N-Pulse/Transradial-Prosthesis-PWR-HW/power_supply (1).pdf

# Power Board

## EPFL N-Pulse

## Lugon-Moulin Johann

EPFL

February 26, 2025

Projet de conception de m´ecanisme: capteur de forces | 3 DESIGN CONSIDERATIONS

## 1 Introduction

The purpose of this report is to explain all the steps leading up to the last version of the PCB. Different design considerations are discussed and explained.

The purpose of this part of the project is to supply the power that comes from the battery to other devices in the arm. For that we need to split it into branches with different voltage and current levels depending on the device (c.f. Figure1).

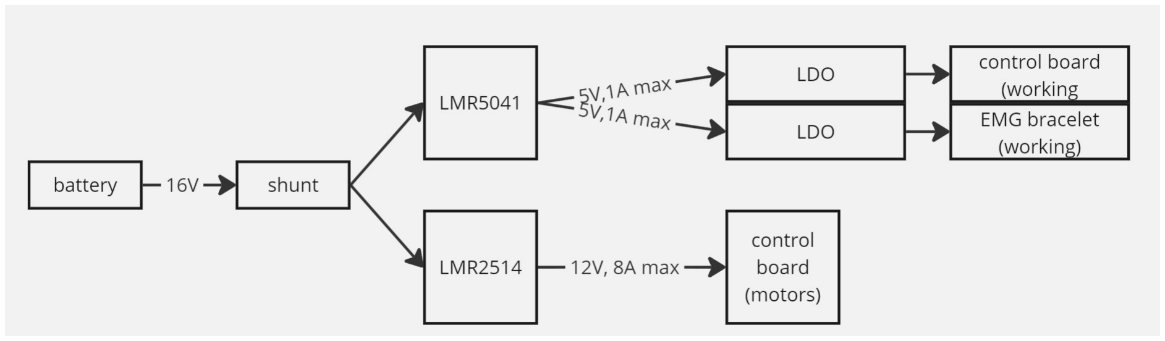
[picture p1: figure]

Figure 1: Schematics

## 2 Requirements

Input : 16.8V to 12V;
Output: 12V (Motors) and 5V (EMG and Control Board);
Size: Mechanical constraints;
Power dissipation : as low as possible to avoid component burning and harming the user.

## 3 Design Considerations

- Current Mirror

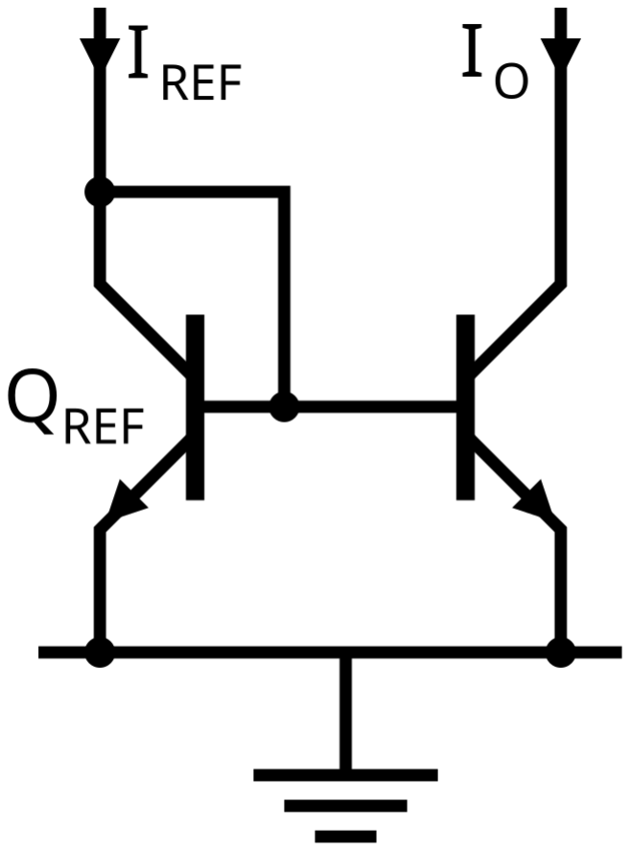
[picture p2: figure]

Figure 2: Current Mirror

The advantage is that it can be easily integrated in a PCB and a simple circuit. However, this design outputs a constant current level regardless of the system’s requirements. Outputting too much current will empty the battery much faster and potentially damage other parts of the system which do not require high current.

- LDO
The LDO system is a way of reducing voltage level through heat dissipation. If the voltage drop is too high the temperature can increase very fast which can damage the PCB. On the other hand, they are simple, inexpensive and the output voltage is low-noise (as opposed to a buck regulator).

Projet de conception de m´ecanisme: capteur de forces | 4 12V CIRCUIT

## 4 12V Circuit

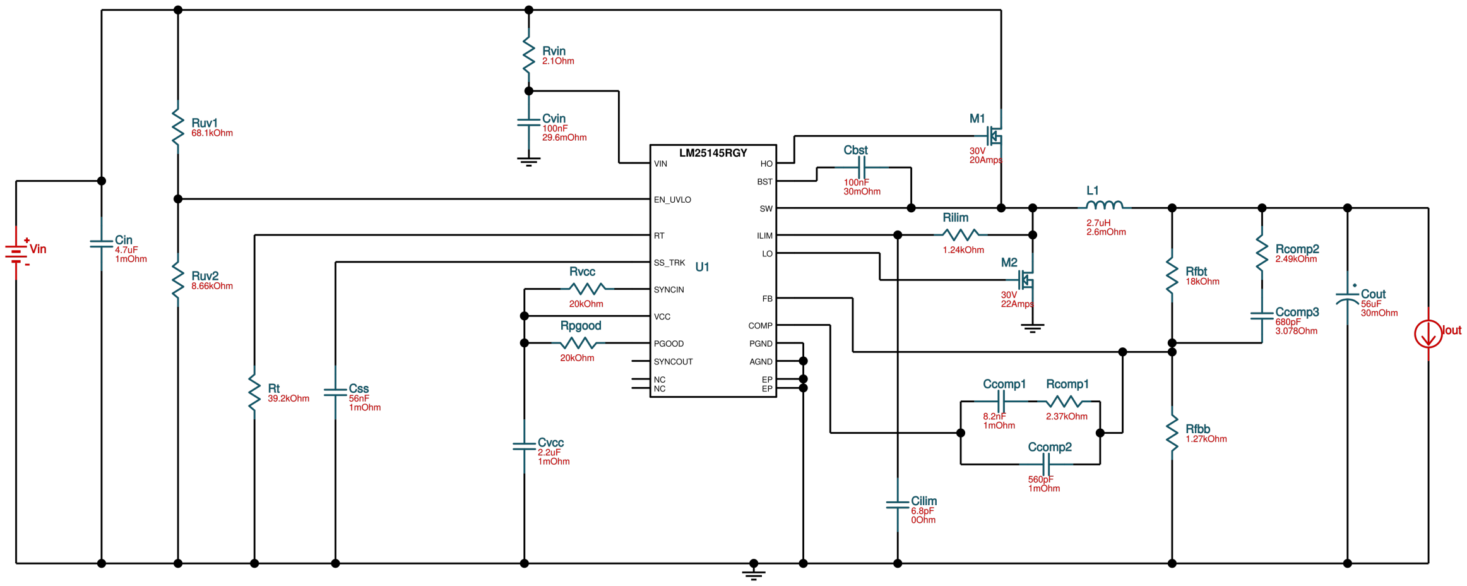
[picture p3: figure]

Figure 3: 12V, 8A circuit designed by Webench

This circuit is made to supply the motors of the arm which work with 12V. To design the circuit, we had to estimated the maximum current value passing through this branch to power the motors. Each motor has a stall current of 0.5A. The arm prosthesis is designed to contain a maximum of 8 motors. As such, the maxmimum current requirements for all the motors in stall mode is 4A. To avoid breaking the system if the current suddenly increases, a safety margin of +0.5A is considered per motor which implies that the circuit should ultimately accept 8A.

### 4.1 Circuit Properties

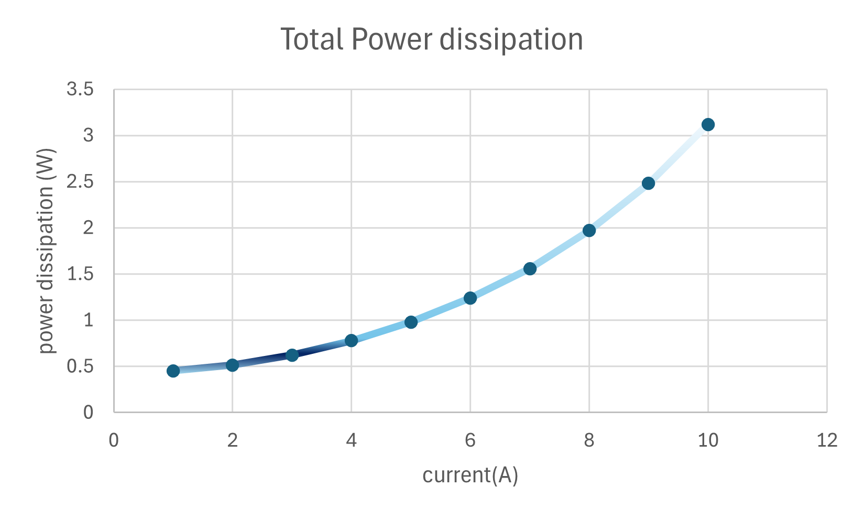
[picture p4: figure]

Figure 4: Caption

### 4.2 Components

Projet de conception de m´ecanisme: capteur de forces | 4 12V CIRCUIT
Category | model | values | mark | number | Figure3
Capacitors | GRM32ER71H475KA88L | 4.7uF50V | murata electronics | 1 | Cin
resistor | CRCW040269K8FKED | 69.8k | Vishay | 1 | Ruv1
resistor | CRCW06038K25FKEA | 8.25k | Vishay | 1 | Ruv2
resistor | CRCW06032R10FKEA | 2.10ohms | Vishay | 1 | Rvin
Condensator | CGA3E2X7R1H104K080AA | 0.1uF | TDK | 1 | Cvin
Resistor | CRCW040239K2FKED | 39.2k | Vishay | 1 | Rt
Condensator | GRM155R71C563KA88D | 56nF | murata electronics | 1 | Css
Condensator | C1005X5R1V225K050BC | 2.2uF | TDK | 1 | Cvcc
resistor | RC0603FR-0720KL | 20k | Yageo | 2 | Rvcc Rpgood
Transitors | CSD17577Q3A | 35A Id, 30V | texas instrument | 1 | M2 M1
condensator | GCM1555C1H100FA16D | 10pF(echange) | Murata electronics | 1 | Cbst
Resistor | CRCW04021K24FKED | 1.24k Ohms | Vishay | 1 | Rilim
Condensator | GRM1885C2A100JA01D | 10pF | murata electronics | 1 | Cilim
Resistor | CRCW04022K37FKED | 2.37k | Vishay | 1 | Rcomp1
Condensator | GRM155R71C822KA01D | 8200pF | Murata Electronics | 1 | Ccomp1
Condensator | CGA2B2X7R1H681K050BA | 680pF | TDK | 1 | Ccomp2
Inductance | SER1360-272KLD | 2.7uH | Coilcraft | 1 | L1
Resistor | RC0603FR-0718KL | 18k | Yageo | 1 | Rf bt
Resistor | CRCW04021K27FKED | 1.27K | Vishay | 1 | Rf bb
Resistor | CRCW04022K49FKED | 2.49k | vishay | 1 | Rcomp2
Condensator | CGA2B2X7R1H681K050BA | 680pF | TDK | 1 | Ccomp3
Condensators | 20SVPF56MX | 56uF | Panasonic | 1 | Cout
- pin connectors
We transfer all the current to the control board with 2 pins that will have a current max of 10A (worst case). The pin have a a pitch of 5mm

### 4.3 PCB traces

We need to be carefull with the traces to avoid that they burns. The current that pass in the trace heat the trace and if the resistance is to high the trace can burn after a certain time. The value of the current is an RMS value. To have security margins, we take the RMS current as 3.5A ( the case where all the motors work at the maximum in the same time). The 8A will not burn our traces because it will occur only in the worst case and a really short time.
We can have multiple ways of impact the surface of the trace to reduce this resistance. The easiest is during the manufacturing with a change in the thickness (more common are 1oz and 2oz). The calculation depend on the ambiant temperature: we take 25°C. It depend on the temperature rise: we take 10°C. There is a calculation to find what to use.
| A =
| | I
| | k · (Trise) b

1
| | c
(1)

W =

A
t · 1.378

(2)

avec :

- A : surface
- W : trace width
- I : Current(A)
- k : Coefficient of proportion for internal layers : 0.024
- Trise : Temperature rise
- b : empirical exposant for internal layers : 0.44
- c : correctionnal exposant for internal layers : 0.725
- t : thickness

Projet de conception de m´ecanisme: capteur de forces | 4 12V CIRCUIT

Results

thickness of 1oz : W = 4, 398786766mm thickness of 2oz : W = 2, 199393383mm

In our PCB, the big traces are only where the current can be high and the other traces are normal (=0.2mm)

Projet de conception de m´ecanisme: capteur de forces | 6 FUSE

## 5 5V Circuit

The purpose of this circuit is to power the Control Board as well as the EMG bracelet. For this section we estimate that the current should not exceed 1A.

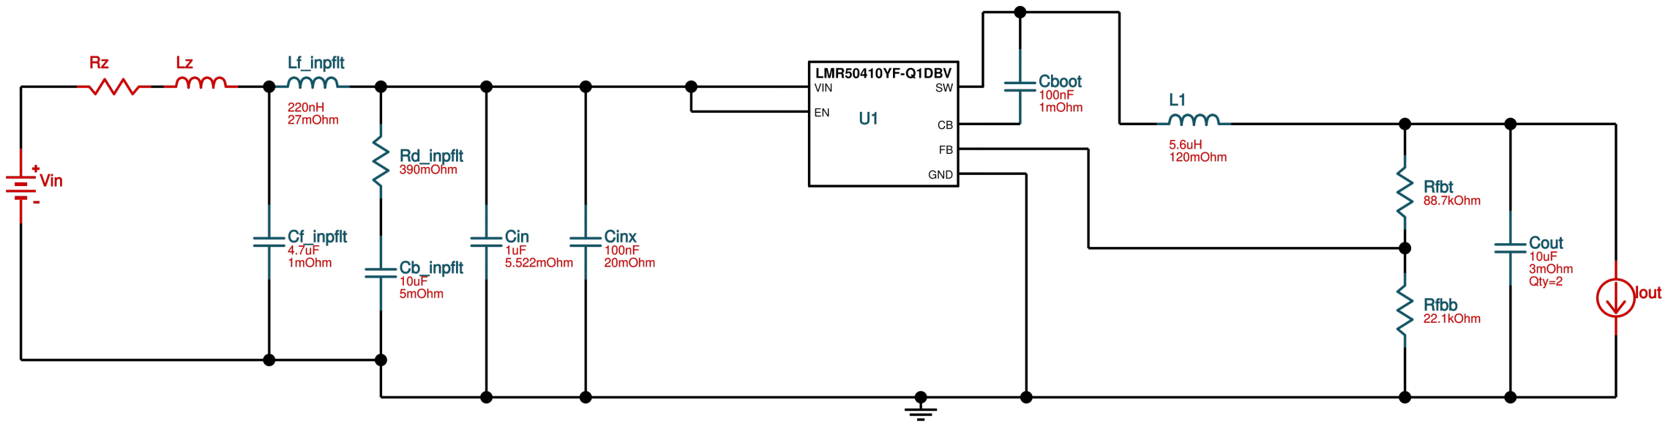
[picture p5: figure]

Figure 5: 5V, 1A Circuit made by Webench

### 5.1 Components

Category | model | values | mark | number | Figure5
Inductor | NLCV32T-R33M-EFRD | 0.33uH | TDK | 1 | Lfinplif t
Capacitors | GRM31CR71H475KA12L | 4.7uF | murata elec | 1 | Cfinplif t
Resistor | CRCW04021R00FKED | 1 ohm | Vishay | 1 | Rdinplif t
Capacitors | C3225X7S2A475M200AB | 10uF | TDK | 1 | Cbinplif t
Capacitors | C1608X5R1E106M080AC | 1uF | TDK | 1 | Cin
Capacitors | GRM188R72A104KA35J | 0.1uF | murata elec | 1 | Cinx
Capacitors | GRM155R71C104KA88D | 0.1uF | murata elec | 1 | Cboot
Inductor | 74438336047 | 4.7uH | wurth electronic | 1 | L1
Resistor | CRCW040288K7FKED | 88.7K | Vishay | 1 | Rf bt
Resistor | CRCW040222K1FKED | 22.1K | Vishay | 1 | Rf bb
Capacitors | C0805C106K8PACTU | 10uF | KEMET | 2 | Cout

## 6 Fuse

The fuse that we have chosen can tolerate a certain amount of peak current (c.f. ”Typical I2t” as shown in Figure 6). The model we selected is the SF-1206HH120M-2. Its nominal current is take to the max that the circuit can tolerate for a long time. All the components of the power board can tolerate 8A.

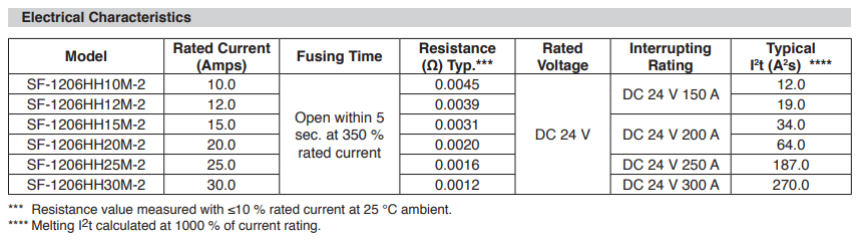
[picture p6: figure]

Figure 6: Fuse Characteristics

Projet de conception de m´ecanisme: capteur de forces | 7 FINAL PCB

## 7 Final PCB

We have a PCB with 2 layers due to the fact that some traces should pass on the bottom layer to avoid to crossing with others.

Final Dimensions: 38.35mm x 37.5mm x 7mm

The 2 holes are to fix the PCB inside the arm and they are M2

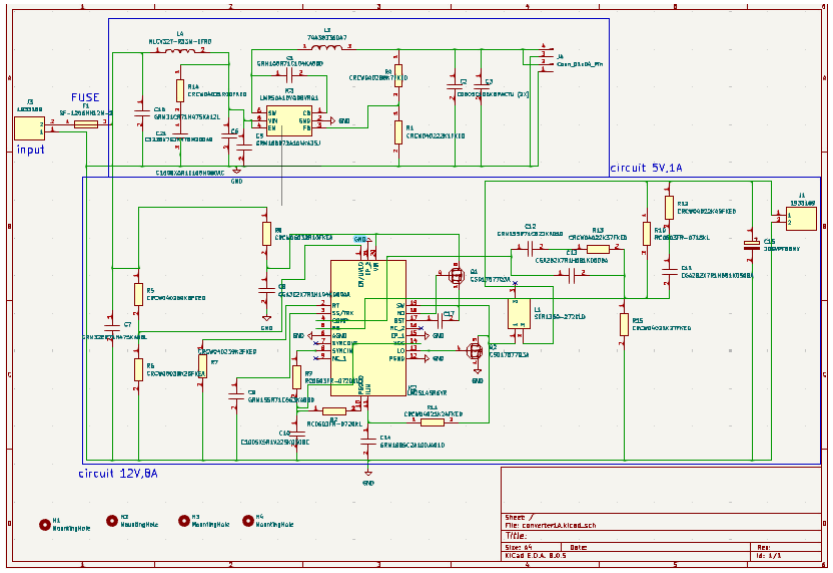
[picture p7: figure]

Figure 7: KiCad Circuit Schematics

Projet de conception de m´ecanisme: capteur de forces | 7 FINAL PCB

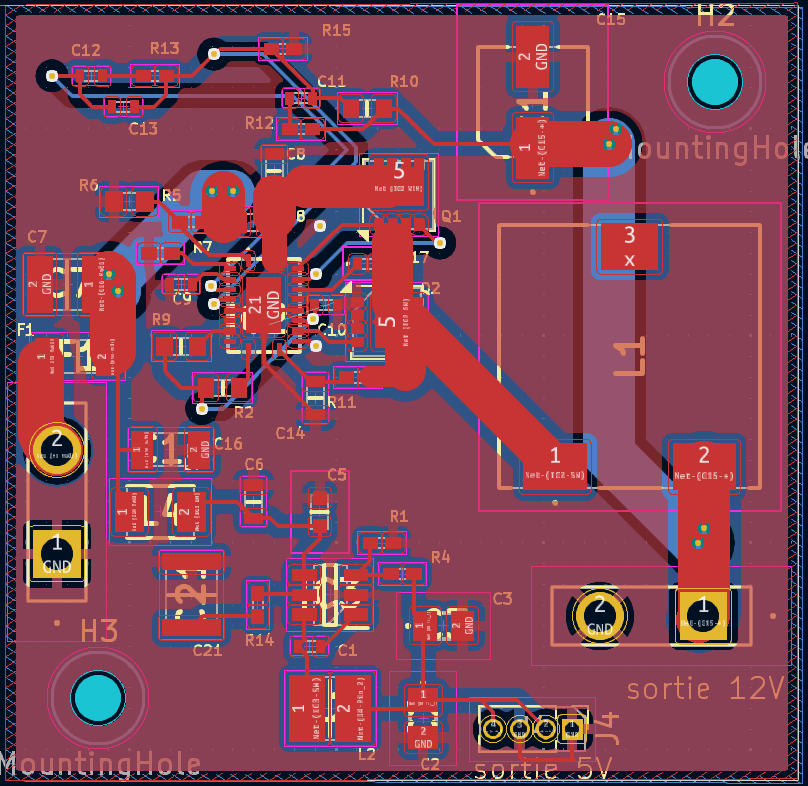
[picture p8: figure]

Figure 8: board PCB

Projet de conception de m´ecanisme: capteur de forces | 7 FINAL PCB

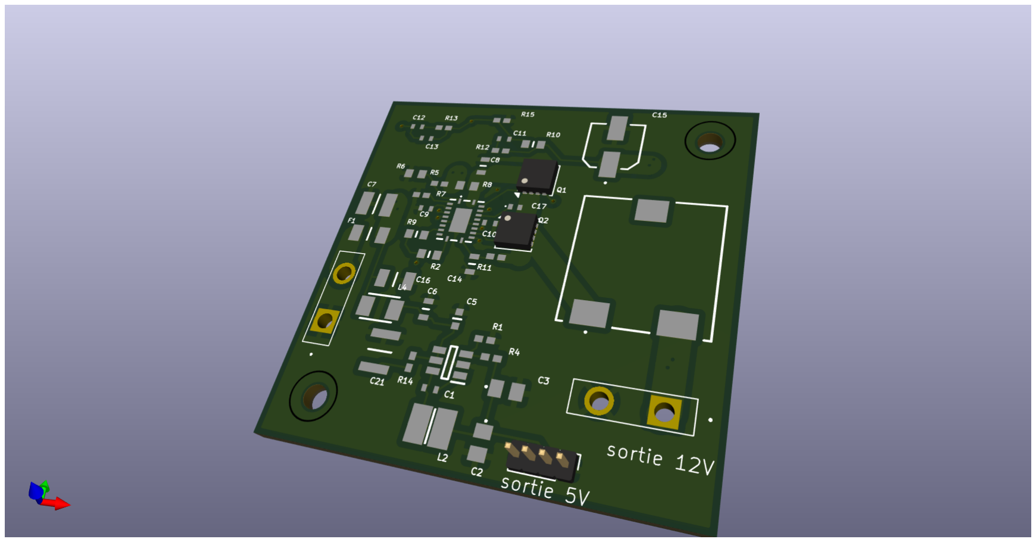
[picture p9: figure]

Figure 9: PCB 3D model
