N-Pulse/Transradial-Prosthesis-PWR-HW/power supply v2/converter1A.kicad_pcb

## KiCad design power supply v2/converter1A.kicad_pcb (2025-03-12)

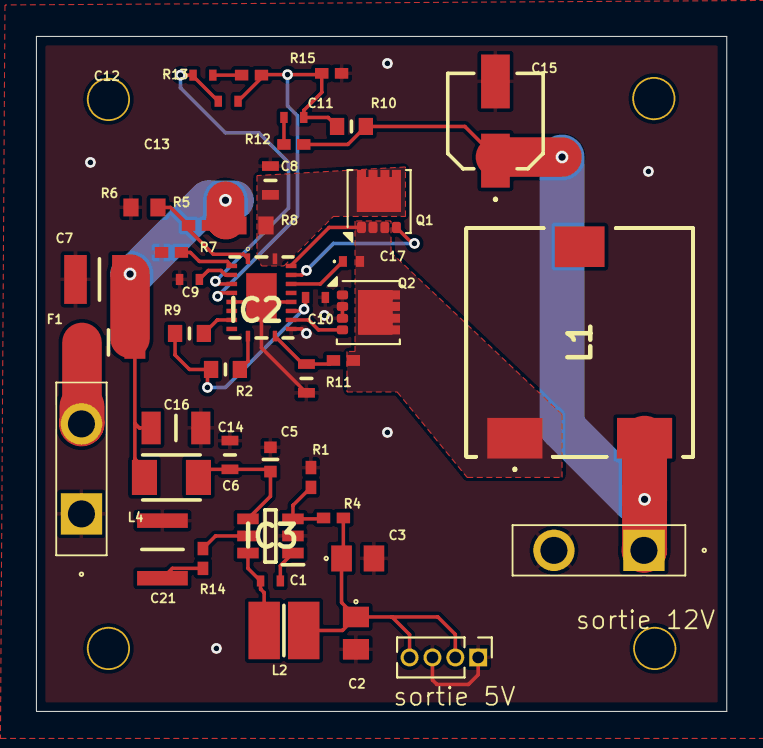
[picture p10: board converter1A.kicad_pcb from above]

Board: 2 copper layers, 38.3 x 37.5 mm, 46 parts (0 on the bottom side), 26 nets.

Parts:
C1: GRM155R71C104KA88D; CAPC1005X55N
C2: C0805C106K8PACTU; C0805
C3: C0805C106K8PACTU (2X); C0805
C5: GRM188R72A104KA35J; GRM18x
C6: C1608X5R1E106M080AC; CAPC1608X80N
C7: GRM32ER71H475KA88L; CAPC3225X270N
C8: CGA3E2X7R1H104K080AA; CAPC1608X90N
C9: GRM155R71C563KA88D; CAPC1005X55N
C10: C1005X5R1V225K050BC; CAPC1005X55N
C11, C13: CGA2B2X7R1H681K050BA; CAPC1005X55N
C12: GRM155R71C822KA01D; CAPC1005X55N
C14: GRM1885C2A100JA01D; CAPC1608X90N
C15: 20SVPF56MX; 16SVF82M
C16: GRM31CR71H475KA12L; CAPC3216X180N
C17: GCM1555C1H100FA16D; GCM155
C21: C3225X7S2A475M200AB; CAPC3225X200N
F1: SF-1206HH12M-2; FUSC3216X117N
H2, H2#2, H3, H3#2: MountingHole; MountingHole_2.2mm_M2
IC2: LM25145RGYR; RGY0020B
IC3: LMR50410YQDBVRQ1; SOT95P280X145-6N
J1, J3: 1933189
J4: Conn_01x04_Pin; PinHeader_1x04_P1.27mm_Vertical
L1: SER1360-272KLD; SER1360272KLD
L2: 74438336047; INDC3030X200N
L4: NLCV32T-R33M-EFRD; INDPM3225X240N
Q1, Q2: CSD17577Q3A; VSON-8_3.3x3.3mm_P0.65mm_NexFET
R1: CRCW040222K1FKED; RESC1005X40N
R2, R9: RC0603FR-0720KL; RESC1608X55N
R4: CRCW040288K7FKED; RESC1005X40N
R5: CRCW040269K8FKED; RESC1005X40N
R6: CRCW06038K25FKEA; RESC1608X50N
R7: CRCW040239K2FKED; RESC1005X40N
R8: CRCW06032R10FKEA; RESC1608X50N
R10: RC0603FR-0718KL; RESC1608X55N
R11: CRCW04021K24FKED; RESC1005X40N
R12: CRCW04022K49FKED; RESC1005X40N
R13: CRCW04022K37FKED; RESC1005X40N
R14: CRCW04021R00FKED; RESC1005X40N
R15: CRCW04021K27FKED; RESC1005X40N

Connections:
GND: C2.2, C3.2, C5.2, C6.2, C7.2, C8.2, C9.2, C10.2, C14.2, C15.2 (-), C16.2, C21.2, IC2.6 (AGND), IC2.12 (PGND), IC2.15 (EP_1), IC2.21 (EP_2), IC3.2 (GND), J1.2, J3.1, J4.1, J4.3, Q2.1 (S), Q2.2 (S), Q2.3 (S), R1.2, R6.2, R7.2, R15.2
unnamed: C11.1, R12.2
unnamed: C12.2, R13.1
unnamed: C15.1 (+), J1.1, L1.2, R10.1, R12.1
unnamed: C7.1, C16.1, F1.2, L4.1, R5.1, R8.1
unnamed: C21.1, R14.2
unnamed: F1.1, J3.2
unnamed: C17.1, IC2.17 (BST)
unnamed: C12.1, C13.1, IC2.4 (COMP)
unnamed: IC2.1 (EN/UVLO), R5.2, R6.1
unnamed: C11.2, C13.2, IC2.5 (FB), R10.2, R13.2, R15.1
unnamed: IC2.18 (HO), Q1.4 (G)
unnamed: C14.1, IC2.11 (ILIM), R11.1
unnamed: IC2.13 (LO), Q2.4 (G)
unnamed: IC2.10 (PGOOD), R2.2
unnamed: IC2.2 (RT), R7.1
unnamed: C9.1, IC2.3 (SS/TRK)
unnamed: C17.2, IC2.19 (SW), L1.1, Q1.1 (S), Q1.2 (S), Q1.3 (S), Q2.5 (D), R11.2
unnamed: IC2.8 (SYNCIN), R9.1
unnamed: C10.1, IC2.14 (VCC), R2.1, R9.2
unnamed: C8.1, IC2.20 (VIN), Q1.5 (D), R8.2
unnamed: C1.2, IC3.1 (CB)
unnamed: C5.1, C6.1, IC3.4 (EN), IC3.5 (VIN), L4.2, R14.1
unnamed: IC3.3 (FB), R1.1, R4.2
unnamed: C1.1, IC3.6 (SW), L2.1
unnamed: C2.1, C3.1, J4.2, J4.4, L2.2, R4.1
