N-Pulse/Transradial-Prosthesis-PWR-HW/(commit log)

2025-02-21 the power board
    maybe the component will not be right
    [converter1A.kicad_pcb]
2025-02-26 version smaller of the PCB
    [converter1A.kicad_pcb, converter1A.kicad_sch]
2025-03-03 v2 of board
    [converter1A.kicad_pcb, converter1A.kicad_sch]
2025-03-07 last version of pcb and gerber files
    [converter1A-B_Cu.gbl, converter1A-B_Mask.gbs, converter1A-B_Paste.gbp, converter1A-B_Silkscreen.gbo, converter1A-Edge_Cuts.gm1, converter1A-F_Cu.gtl, converter1A-F_Mask.gts, converter1A-F_Paste.gtp]
2025-03-07 add measurement annotations and move the top right screw up by 0.27mm for standardisation
    [converter1A.kicad_pcb]
2025-03-08 add 2 2.4mm screw holes and regenerate gerber files
    [converter1A-B_Cu.gbl, converter1A-B_Mask.gbs, converter1A-B_Paste.gbp, converter1A-B_Silkscreen.gbo, converter1A-Edge_Cuts.gm1, converter1A-F_Cu.gtl, converter1A-F_Mask.gts, converter1A-F_Paste.gtp]
2025-03-12 add license
    [converter1A.kicad_pcb, converter1A.kicad_sch]
